Alwwex/Projekt_velky/hardware/kicad/drc_report.txt

** Drc report for /home/user/Projekt_velky/hardware/kicad/laserplan.kicad_pcb **
** Created on 2026-11-11 16:36:16 **

** Found 56 DRC violations **
[lib_footprint_issues]: The current configuration does not include the library 'Resistor_SMD'.
    Local override; Severity: warning
    @(145.0000 mm, 126.5000 mm): Footprint R19
[lib_footprint_issues]: The current configuration does not include the library 'Resistor_SMD'.
    Local override; Severity: warning
    @(136.5000 mm, 104.6000 mm): Footprint R7
[lib_footprint_issues]: The current configuration does not include the library 'MountingHole'.
    Local override; Severity: warning
    @(103.2000 mm, 140.8000 mm): Footprint H3
[lib_footprint_issues]: The current configuration does not include the library 'Resistor_SMD'.
    Local override; Severity: warning
    @(172.2000 mm, 109.6000 mm): Footprint R11
[lib_footprint_issues]: The current configuration does not include the library 'LED_SMD'.
    Local override; Severity: warning
    @(186.7000 mm, 136.5000 mm): Footprint D3
[lib_footprint_issues]: The current configuration does not include the library 'Capacitor_SMD'.
    Local override; Severity: warning
    @(159.2000 mm, 133.5000 mm): Footprint C10
[lib_footprint_issues]: The current configuration does not include the library 'Resistor_SMD'.
    Local override; Severity: warning
    @(179.0000 mm, 129.4000 mm): Footprint R1
[lib_footprint_issues]: The current configuration does not include the library 'Resistor_SMD'.
    Local override; Severity: warning
    @(157.0000 mm, 133.5000 mm): Footprint R15
[lib_footprint_issues]: The current configuration does not include the library 'Connector_PinSocket_2.54mm'.
    Local override; Severity: warning
    @(130.5000 mm, 117.1900 mm): Footprint J3
[lib_footprint_issues]: The current configuration does not include the library 'Capacitor_SMD'.
    Local override; Severity: warning
    @(175.4000 mm, 105.6000 mm): Footprint C4
[lib_footprint_issues]: The current configuration does not include the library 'Package_TO_SOT_SMD'.
    Local override; Severity: warning
    @(175.0000 mm, 126.0000 mm): Footprint Q1
[lib_footprint_issues]: The current configuration does not include the library 'Capacitor_SMD'.
    Local override; Severity: warning
    @(136.5000 mm, 107.2000 mm): Footprint C7
[lib_footprint_issues]: The current configuration does not include the library 'Button_Switch_THT'.
    Local override; Severity: warning
    @(134.5000 mm, 111.5000 mm): Footprint SW3
[lib_footprint_issues]: The current configuration does not include the library 'Capacitor_SMD'.
    Local override; Severity: warning
    @(170.8000 mm, 133.0000 mm): Footprint C2
[lib_footprint_issues]: The current configuration does not include the library 'MountingHole'.
    Local override; Severity: warning
    @(186.8000 mm, 140.8000 mm): Footprint H4
[lib_footprint_issues]: The current configuration does not include the library 'Package_TO_SOT_SMD'.
    Local override; Severity: warning
    @(151.0000 mm, 137.0000 mm): Footprint Q2
[lib_footprint_issues]: The current configuration does not include the library 'Resistor_SMD'.
    Local override; Severity: warning
    @(164.0000 mm, 128.5000 mm): Footprint R16
[lib_footprint_issues]: The current configuration does not include the library 'Resistor_SMD'.
    Local override; Severity: warning
    @(157.5000 mm, 129.0000 mm): Footprint R17
[lib_footprint_issues]: The current configuration does not include the library 'MountingHole'.
    Local override; Severity: warning
    @(103.2000 mm, 103.2000 mm): Footprint H1
[lib_footprint_issues]: The current configuration does not include the library 'Connector_JST'.
    Local override; Severity: warning
    @(174.0000 mm, 139.6000 mm): Footprint J4
[lib_footprint_issues]: The current configuration does not include the library 'LED_SMD'.
    Local override; Severity: warning
    @(186.7000 mm, 134.0000 mm): Footprint D2
[lib_footprint_issues]: The current configuration does not include the library 'Resistor_SMD'.
    Local override; Severity: warning
    @(177.8000 mm, 125.5000 mm): Footprint R6
[lib_footprint_issues]: The current configuration does not include the library 'Resistor_SMD'.
    Local override; Severity: warning
    @(175.8000 mm, 109.6000 mm): Footprint R12
[lib_footprint_issues]: The current configuration does not include the library 'LED_SMD'.
    Local override; Severity: warning
    @(145.0000 mm, 129.0000 mm): Footprint D5
[lib_footprint_issues]: The current configuration does not include the library 'Resistor_SMD'.
    Local override; Severity: warning
    @(168.5000 mm, 109.0000 mm): Footprint R9
[lib_footprint_issues]: The current configuration does not include the library 'Diode_SMD'.
    Local override; Severity: warning
    @(147.5000 mm, 136.2000 mm): Footprint D4
[lib_footprint_issues]: The current configuration does not include the library 'MountingHole'.
    Local override; Severity: warning
    @(186.8000 mm, 103.2000 mm): Footprint H2
[lib_footprint_issues]: The current configuration does not include the library 'Diode_SMD'.
    Local override; Severity: warning
    @(175.0000 mm, 121.5000 mm): Footprint D1
[lib_footprint_issues]: The current configuration does not include the library 'Package_TO_SOT_SMD'.
    Local override; Severity: warning
    @(174.5000 mm, 133.0000 mm): Footprint U2
[lib_footprint_issues]: The current configuration does not include the library 'Package_TO_SOT_SMD'.
    Local override; Severity: warning
    @(161.0000 mm, 129.0000 mm): Footprint Q3
[lib_footprint_issues]: The current configuration does not include the library 'Resistor_SMD'.
    Local override; Severity: warning
    @(179.0000 mm, 119.0000 mm): Footprint R2
[lib_footprint_issues]: The current configuration does not include the library 'Capacitor_SMD'.
    Local override; Severity: warning
    @(178.5000 mm, 133.0000 mm): Footprint C1
[lib_footprint_issues]: The current configuration does not include the library 'Package_TO_SOT_SMD'.
    Local override; Severity: warning
    @(149.0000 mm, 131.5000 mm): Footprint Q4
[lib_footprint_issues]: The current configuration does not include the library 'Buzzer_Beeper'.
    Local override; Severity: warning
    @(135.5000 mm, 137.6000 mm): Footprint BZ1
[lib_footprint_issues]: The current configuration does not include the library 'Resistor_SMD'.
    Local override; Severity: warning
    @(145.5000 mm, 123.3000 mm): Footprint R10
[lib_footprint_issues]: The current configuration does not include the library 'Package_TO_SOT_SMD'.
    Local override; Severity: warning
    @(178.5000 mm, 105.5000 mm): Footprint U3
[lib_footprint_issues]: The current configuration does not include the library 'Capacitor_SMD'.
    Local override; Severity: warning
    @(181.6000 mm, 105.6000 mm): Footprint C3
[lib_footprint_issues]: The current configuration does not include the library 'Connector_USB'.
    Local override; Severity: warning
    @(186.3000 mm, 124.0000 mm): Footprint J1
[lib_footprint_issues]: The current configuration does not include the library 'Capacitor_SMD'.
    Local override; Severity: warning
    @(179.4000 mm, 109.6000 mm): Footprint C8
[lib_footprint_issues]: The current configuration does not include the library 'Resistor_SMD'.
    Local override; Severity: warning
    @(183.2000 mm, 136.5000 mm): Footprint R5
[lib_footprint_issues]: The current configuration does not include the library 'Capacitor_SMD'.
    Local override; Severity: warning
    @(141.0000 mm, 104.6000 mm): Footprint C5
[lib_footprint_issues]: The current configuration does not include the library 'RF_Module'.
    Local override; Severity: warning
    @(157.0000 mm, 113.3500 mm): Footprint U4
[lib_footprint_issues]: The current configuration does not include the library 'Jumper'.
    Local override; Severity: warning
    @(153.0000 mm, 127.0000 mm): Footprint JP1
[lib_footprint_issues]: The current configuration does not include the library 'Button_Switch_THT'.
    Local override; Severity: warning
    @(122.0000 mm, 102.2500 mm): Footprint SW1
[lib_footprint_issues]: The current configuration does not include the library 'Capacitor_SMD'.
    Local override; Severity: warning
    @(154.5000 mm, 137.0000 mm): Footprint C9
[lib_footprint_issues]: The current configuration does not include the library 'Button_Switch_THT'.
    Local override; Severity: warning
    @(134.5000 mm, 122.5000 mm): Footprint SW2
[lib_footprint_issues]: The current configuration does not include the library 'Resistor_SMD'.
    Local override; Severity: warning
    @(152.5000 mm, 131.5000 mm): Footprint R18
[lib_footprint_issues]: The current configuration does not include the library 'Resistor_SMD'.
    Local override; Severity: warning
    @(183.2000 mm, 134.0000 mm): Footprint R4
[lib_footprint_issues]: The current configuration does not include the library 'Resistor_SMD'.
    Local override; Severity: warning
    @(149.5000 mm, 123.3000 mm): Footprint R8
[lib_footprint_issues]: The current configuration does not include the library 'Capacitor_SMD'.
    Local override; Severity: warning
    @(141.0000 mm, 107.2000 mm): Footprint C6
[lib_footprint_issues]: The current configuration does not include the library 'Resistor_SMD'.
    Local override; Severity: warning
    @(144.5000 mm, 110.0000 mm): Footprint R20
[lib_footprint_issues]: The current configuration does not include the library 'Resistor_SMD'.
    Local override; Severity: warning
    @(174.5000 mm, 129.6000 mm): Footprint R3
[lib_footprint_issues]: The current configuration does not include the library 'Package_TO_SOT_SMD'.
    Local override; Severity: warning
    @(170.8000 mm, 114.1000 mm): Footprint U1
[lib_footprint_issues]: The current configuration does not include the library 'Resistor_SMD'.
    Local override; Severity: warning
    @(184.0000 mm, 112.0000 mm): Footprint R13
[lib_footprint_issues]: The current configuration does not include the library 'Connector_PinHeader_2.54mm'.
    Local override; Severity: warning
    @(149.0000 mm, 141.6000 mm): Footprint J2
[lib_footprint_issues]: The current configuration does not include the library 'Resistor_SMD'.
    Local override; Severity: warning
    @(184.0000 mm, 108.6000 mm): Footprint R14

** Found 0 unconnected pads **

** Found 0 Footprint errors **

** End of Report **
