Alwwex/Projekt_velky/hardware/vyroba/bom-jlcpcb.csv

Comment | Designator | Footprint | LCSC Part # | MPN
10u | C1,C2,C3,C4,C5,C9 | C_0805_2012Metric |  | 0805 10u X5R/X7R ≥10V
10n | C10 | C_0805_2012Metric |  | 0805 10n X5R/X7R ≥10V
100n | C6,C8 | C_0805_2012Metric |  | 0805 100n X5R/X7R ≥10V
1u | C7 | C_0805_2012Metric |  | 0805 1u X5R/X7R ≥10V
B5819W | D1 | D_SOD-123 |  | B5819W
LED červená | D2 | LED_0805_2012Metric |  | LED 0805 červená
LED zelená | D3 | LED_0805_2012Metric |  | LED 0805 zelená
1N4148W | D4 | D_SOD-123 |  | 1N4148W
LED modrá | D5 | LED_0805_2012Metric |  | LED 0805 modrá
USB-C | J1 | USB_C_Receptacle_HRO_TYPE-C-31-M-12 |  | TYPE-C-31-M-12
AO3401A | Q1,Q2 | SOT-23 |  | AO3401A
AO3400A | Q3,Q4 | SOT-23 |  | AO3400A
5.1k | R1,R2 | R_0805_2012Metric |  | 0805 5.1k 1%
47k | R13 | R_0805_2012Metric |  | 0805 47k 1%
68k | R14 | R_0805_2012Metric |  | 0805 68k 1%
2.2k | R3 | R_0805_2012Metric |  | 0805 2.2k 1%
1k | R4,R5,R19 | R_0805_2012Metric |  | 0805 1k 1%
100k | R6,R11,R12,R15,R16,R18 | R_0805_2012Metric |  | 0805 100k 1%
10k | R7,R8,R9,R10,R17,R20 | R_0805_2012Metric |  | 0805 10k 1%
USBLC6-2SC6 | U1 | SOT-23-6 |  | USBLC6-2SC6
MCP73831-2-OT | U2 | SOT-23-5 |  | MCP73831T-2ACI/OT
AP2112K-3.3 | U3 | SOT-23-5 |  | AP2112K-3.3TRG1
ESP32-C3-WROOM-02-N4 | U4 | ESP32-C3-WROOM-02 |  | ESP32-C3-WROOM-02-N4
