Alwwex/Projekt_velky/hardware/krabicka/vicko.stl

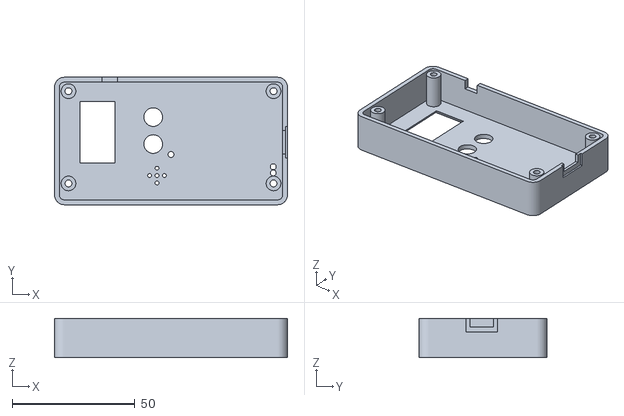
[picture p6: CAD file, 2026-11-11]
hardware/krabicka/vicko.stl
95.0 x 52.0 x 16.0
