Alwwex/Projekt_velky/hardware/vyroba/laserplan.step

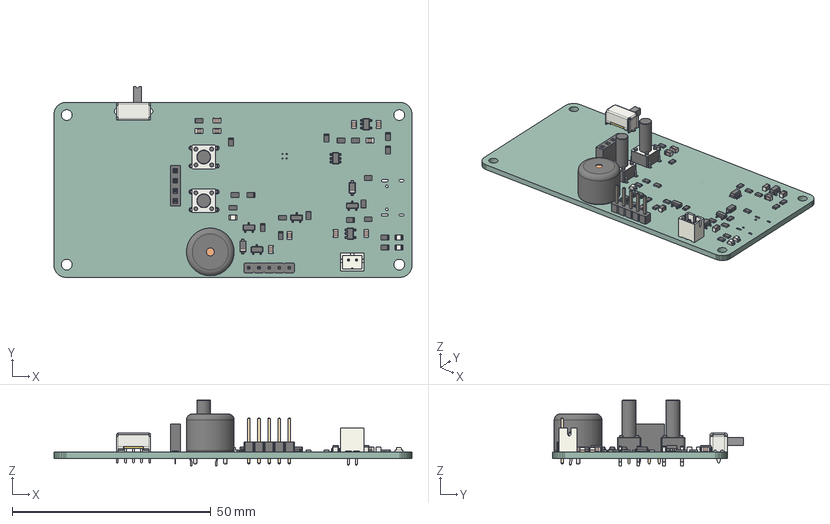
[picture p7: CAD file, 2026-11-11]
hardware/vyroba/laserplan.step
90.0 x 48.0 x 16.5 mm
R_0805_2012Metric x 20
LED_0805_2012Metric x 3
C_0805_2012Metric x 10
PinSocket_1x04_P254mm_Vertical
SOT_23 x 4
SW_PUSH_6mm_h13mm x 2
JST_B2B_PH_K
D_SOD_123 x 2
SOT_23_5 x 2
Buzzer_12x95RM76
SW_Slide_SPDT_Angled_CK_OS102011MA1Q
SOT_23_6
PinHeader_1x05_P254mm_Vertical
laserplan PCB
