Alwwex/Projekt_velky/hardware/krabicka/spodek.stl

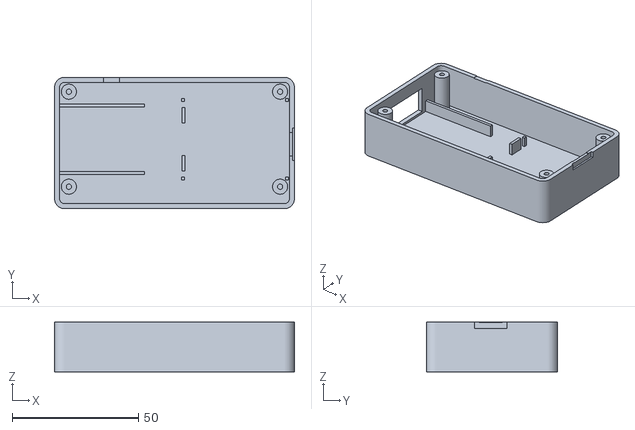
[picture p8: CAD file, 2026-11-11]
hardware/krabicka/spodek.stl
95.0 x 52.0 x 19.6
