Alwwex/Projekt_velky/hardware/krabicka/hmatnik.stl

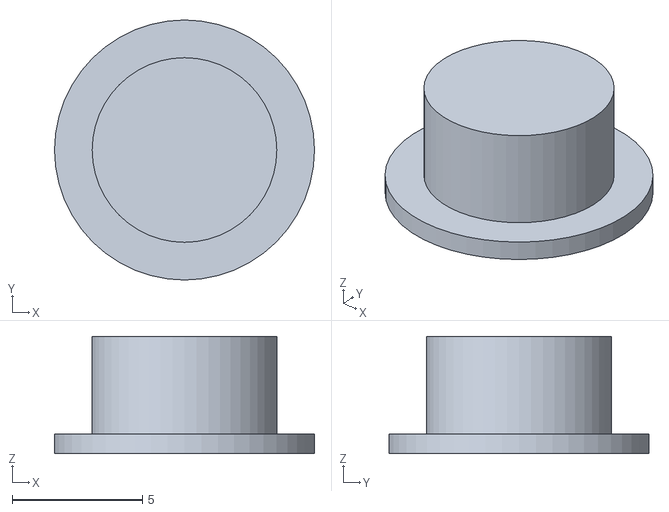
[picture p9: CAD file, 2026-11-11]
hardware/krabicka/hmatnik.stl
10.0 x 10.0 x 4.50
