Alwwex/Projekt_velky/hardware/vyroba/schema.pdf

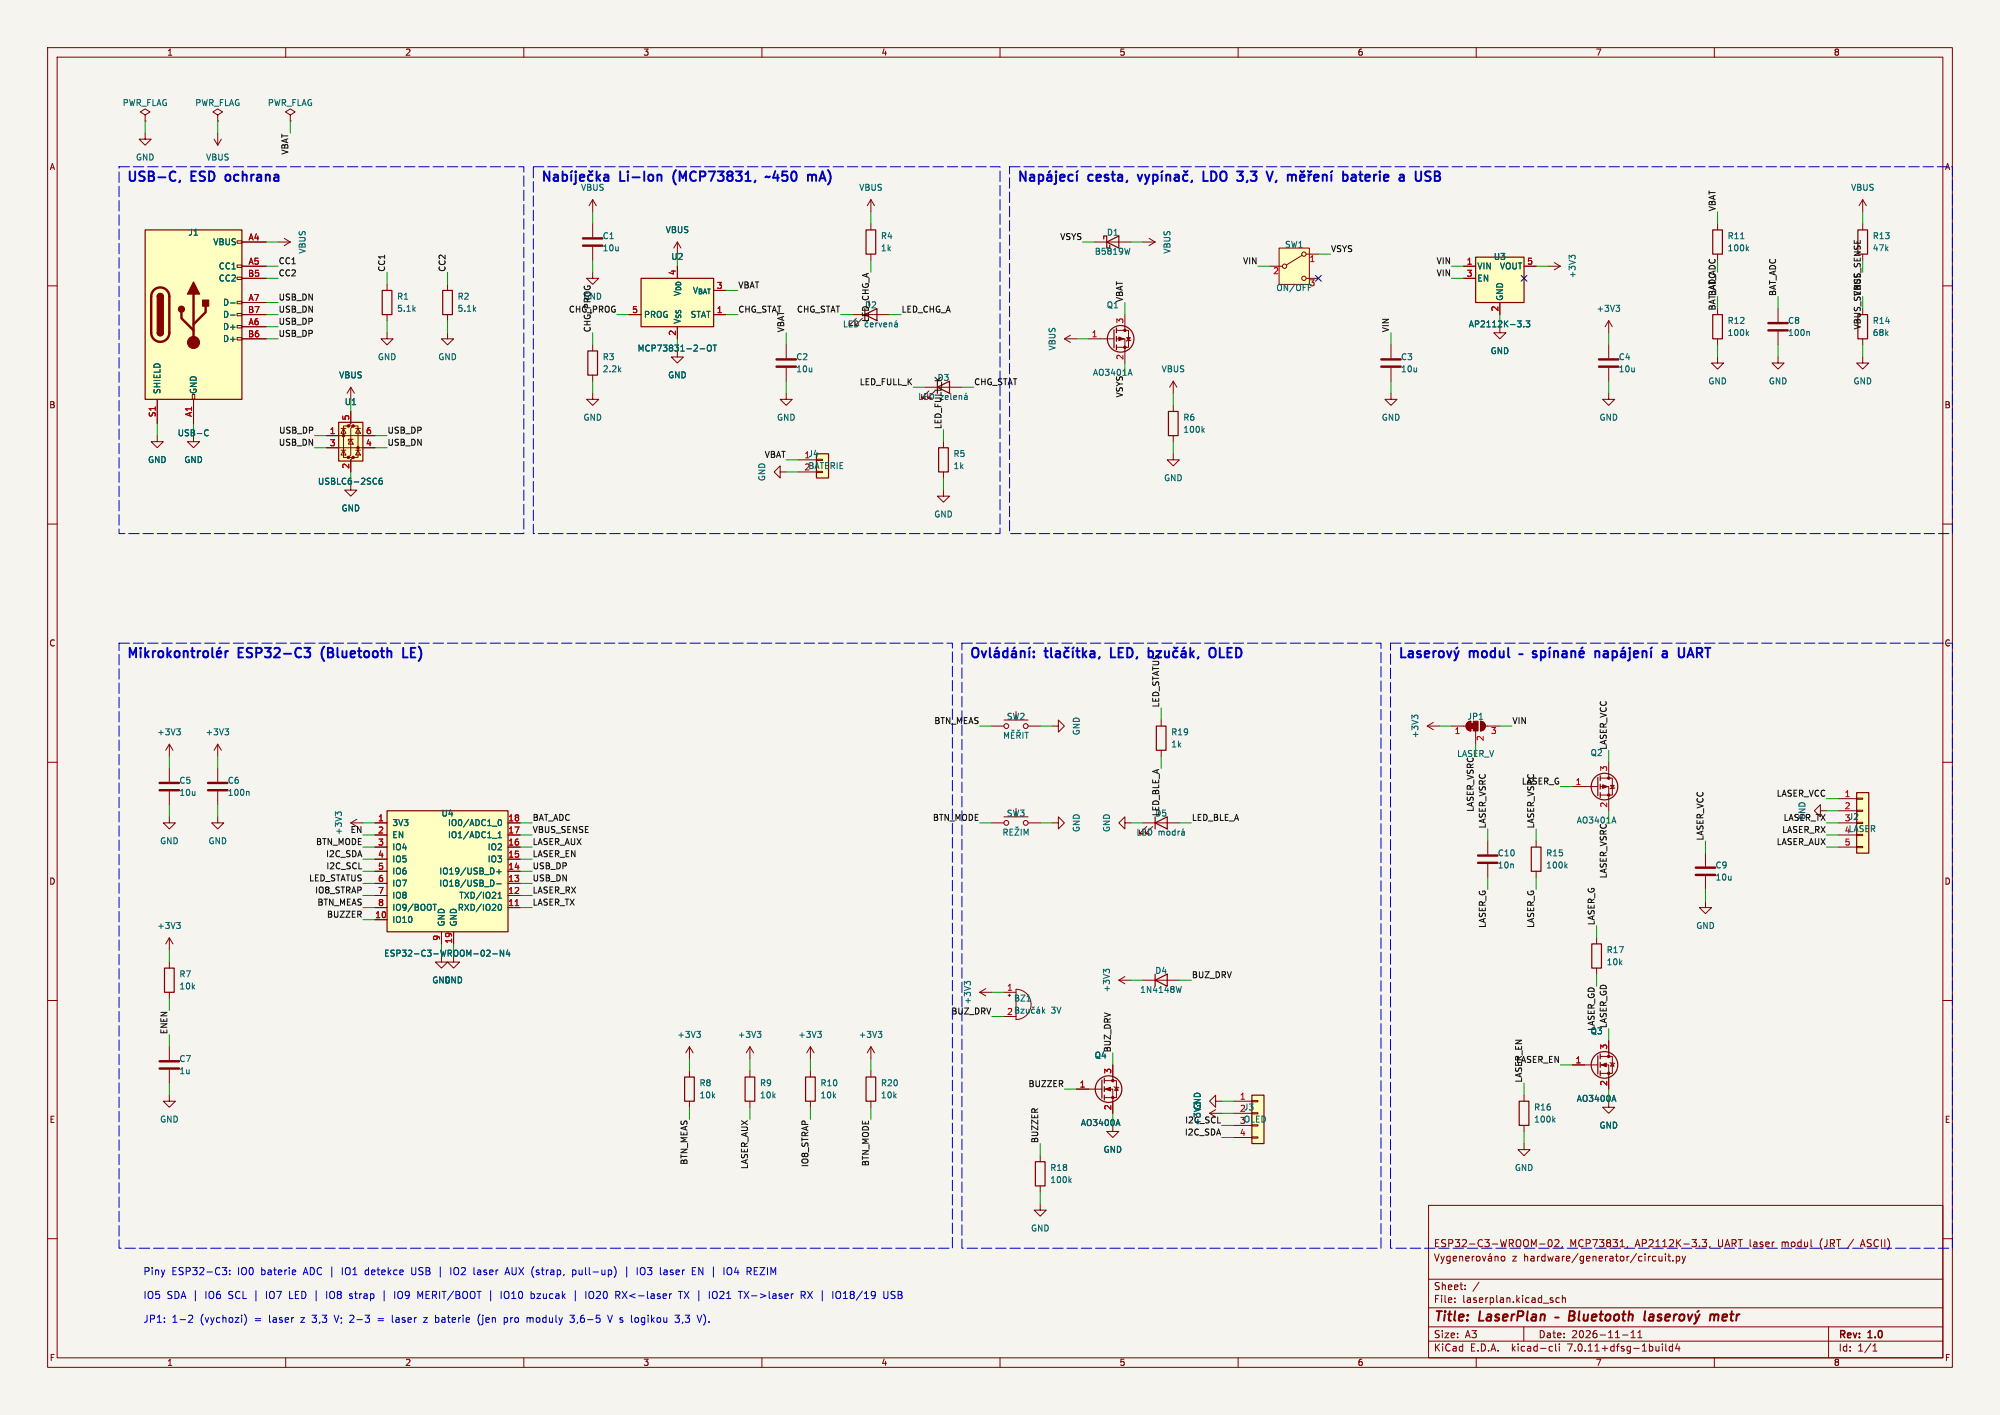
[picture p10: page 1]

, LDO 3,3 V, þÿmYení baterie a USB

2 3 Q3 AO3400A GND GND A1 VBUS A4 CC1 A5 D+ A6 D- A7 CC2 B5 D+ B6 D- B7 SHIELD S1

2 EN 3 VOUT 5 GND GND
