Alwwex/Projekt_velky/hardware/kicad/laserplan.kicad_pcb

## KiCad design hardware/kicad/laserplan.kicad_pcb (2026-11-11)

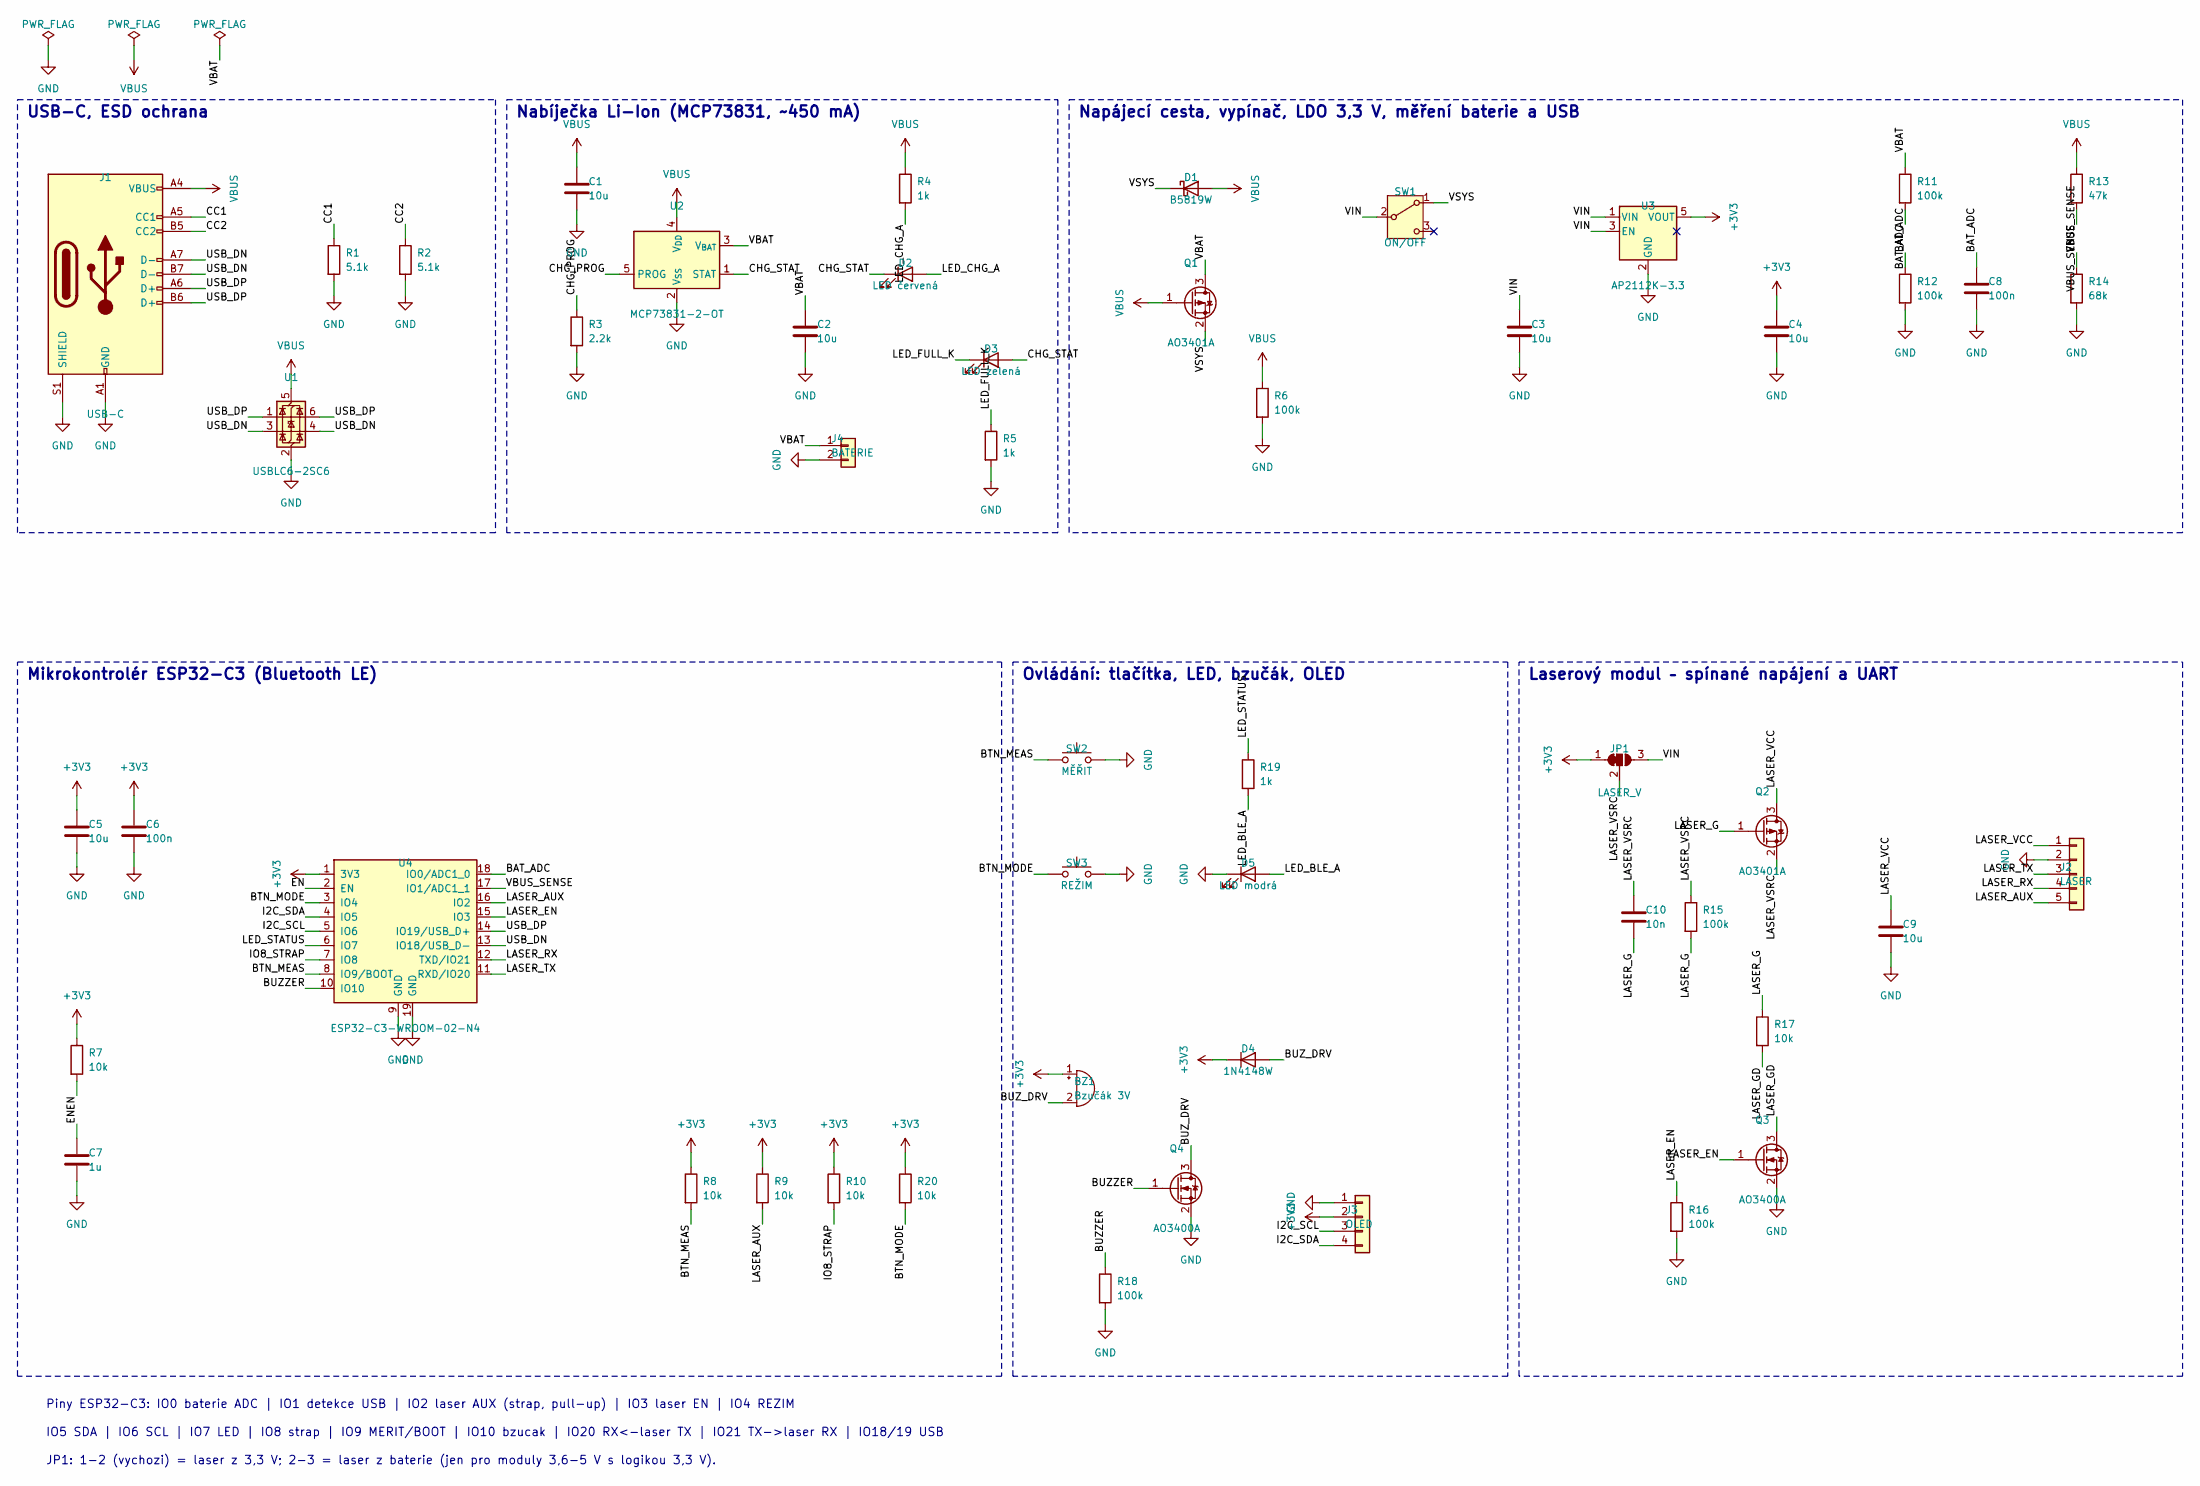
[picture p11: schematic laserplan.kicad_sch, LaserPlan – Bluetooth laserový metr]

Parts:
BZ1: Bzučák 3V; Buzzer_12x9.5RM7.6; MPN Pasivní magnetický bzučák 12×9,5 mm, 3 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
C1, C2, C3, C4, C5, C9: 10u; C_0805_2012Metric; MPN 0805 10u X5R/X7R ≥10V
C6, C8: 100n; C_0805_2012Metric; MPN 0805 100n X5R/X7R ≥10V
C7: 1u; C_0805_2012Metric; MPN 0805 1u X5R/X7R ≥10V
C10: 10n; C_0805_2012Metric; MPN 0805 10n X5R/X7R ≥10V
D1: B5819W; D_SOD-123; MPN B5819W
D2: LED červená; LED_0805_2012Metric; MPN LED 0805 červená
D3: LED zelená; LED_0805_2012Metric; MPN LED 0805 zelená
D4: 1N4148W; D_SOD-123; MPN 1N4148W
D5: LED modrá; LED_0805_2012Metric; MPN LED 0805 modrá
J1: USB-C; USB_C_Receptacle_HRO_TYPE-C-31-M-12; MPN TYPE-C-31-M-12
J2: LASER; PinHeader_1x05_P2.54mm_Vertical; MPN Kolíková lišta 1×5, 2,54 mm
J3: OLED; PinSocket_1x04_P2.54mm_Vertical; MPN Dutinková lišta 1×4, 2,54 mm
J4: BATERIE; JST_PH_B2B-PH-K_1x02_P2.00mm_Vertical; MPN B2B-PH-K-S
JP1: LASER_V; SolderJumper-3_P1.3mm_Bridged12_RoundedPad1.0x1.5mm; MPN (pájecí propojka na DPS)
Q1, Q2: AO3401A; SOT-23; MPN AO3401A
Q3, Q4: AO3400A; SOT-23; MPN AO3400A
R1, R2: 5.1k; R_0805_2012Metric; MPN 0805 5.1k 1%
R3: 2.2k; R_0805_2012Metric; MPN 0805 2.2k 1%
R4, R5, R19: 1k; R_0805_2012Metric; MPN 0805 1k 1%
R6, R11, R12, R15, R16, R18: 100k; R_0805_2012Metric; MPN 0805 100k 1%
R7, R8, R9, R10, R17, R20: 10k; R_0805_2012Metric; MPN 0805 10k 1%
R13: 47k; R_0805_2012Metric; MPN 0805 47k 1%
R14: 68k; R_0805_2012Metric; MPN 0805 68k 1%
SW1: ON/OFF; SW_Slide_SPDT_Angled_CK_OS102011MA1Q; MPN OS102011MA1QN1
SW2: MĚŘIT; SW_PUSH_6mm_H13mm; MPN TS-1187A / B3F-1070 (6×6 mm, výška 13 m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
SW3: REŽIM; SW_PUSH_6mm_H13mm; MPN TS-1187A / B3F-1070 (6×6 mm, výška 13 m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
U1: USBLC6-2SC6; SOT-23-6; MPN USBLC6-2SC6
U2: MCP73831-2-OT; SOT-23-5; MPN MCP73831T-2ACI/OT
U3: AP2112K-3.3; SOT-23-5; MPN AP2112K-3.3TRG1
U4: ESP32-C3-WROOM-02-N4; ESP32-C3-WROOM-02; MPN ESP32-C3-WROOM-02-N4

Connections:
+3V3: BZ1.1 (+), C4.1, C5.1, C6.1, D4.1 (K), J3.2, JP1.1 (A), R7.1, R8.1, R9.1, R10.1, R20.1, U3.5 (VOUT), U4.1 (3V3)
BAT_ADC: C8.1, R11.2, R12.1, U4.18 (IO0/ADC1_0)
BTN_MEAS: R8.2, SW2.1, U4.8 (IO9/BOOT)
BTN_MODE: R20.2, SW3.1, U4.3 (IO4)
BUZZER: Q4.1 (G), R18.1, U4.10 (IO10)
BUZ_DRV: BZ1.2 (-), D4.2 (A), Q4.3 (D)
CC1: J1.A5 (CC1), R1.1
CC2: J1.B5 (CC2), R2.1
CHG_PROG: R3.1, U2.5 (PROG)
CHG_STAT: D2.1 (K), D3.2 (A), U2.1 (STAT)
EN: C7.1, R7.2, U4.2 (EN)
GND: C1.2, C2.2, C3.2, C4.2, C5.2, C6.2, C7.2, C8.2, C9.2, D5.1 (K), J1.A1 (GND), J1.A12 (GND), J1.B1 (GND), J1.B12 (GND), J1.S1 (SHIELD), J2.2, J3.1, J4.2, Q3.2 (S), Q4.2 (S), R1.2, R2.2, R3.2, R5.2, R6.2, R12.2, R14.2, R16.2, R18.2, SW2.2, SW3.2, U1.2 (GND), U2.2 (V_{SS}), U3.2 (GND), U4.9 (GND), U4.19 (GND)
I2C_SCL: J3.3, U4.5 (IO6)
I2C_SDA: J3.4, U4.4 (IO5)
IO8_STRAP: R10.2, U4.7 (IO8)
LASER_AUX: J2.5, R9.2, U4.16 (IO2)
LASER_EN: Q3.1 (G), R16.1, U4.15 (IO3)
LASER_G: C10.2, Q2.1 (G), R15.2, R17.1
LASER_GD: Q3.3 (D), R17.2
LASER_RX: J2.4, U4.12 (TXD/IO21)
LASER_TX: J2.3, U4.11 (RXD/IO20)
LASER_VCC: C9.1, J2.1, Q2.3 (D)
LASER_VSRC: C10.1, JP1.2 (C), Q2.2 (S), R15.1
LED_BLE_A: D5.2 (A), R19.2
LED_CHG_A: D2.2 (A), R4.2
LED_FULL_K: D3.1 (K), R5.1
LED_STATUS: R19.1, U4.6 (IO7)
USB_DN: J1.A7 (D-), J1.B7 (D-), U1.3 (I/O2), U1.4 (I/O2), U4.13 (IO18/USB_D-)
USB_DP: J1.A6 (D+), J1.B6 (D+), U1.1 (I/O1), U1.6 (I/O1), U4.14 (IO19/USB_D+)
VBAT: C2.1, J4.1, Q1.3 (D), R11.1, U2.3 (V_{BAT})
VBUS: C1.1, D1.2 (A), J1.A4 (VBUS), J1.A9 (VBUS), J1.B4 (VBUS), J1.B9 (VBUS), Q1.1 (G), R4.1, R6.1, R13.1, U1.5 (VBUS), U2.4 (V_{DD})
VBUS_SENSE: R13.2, R14.1, U4.17 (IO1/ADC1_1)
VIN: C3.1, JP1.3 (B), SW1.2 (B), U3.1 (VIN), U3.3 (EN)
VSYS: D1.1 (K), Q1.2 (S), SW1.1 (A)

Notes on the sheet:
USB-C, ESD ochrana
Nabíječka Li-Ion (MCP73831, ~450 mA)
Napájecí cesta, vypínač, LDO 3,3 V, měření baterie a USB
Mikrokontrolér ESP32-C3 (Bluetooth LE)
Ovládání: tlačítka, LED, bzučák, OLED
Laserový modul – spínané napájení a UART
Piny ESP32-C3: IO0 baterie ADC | IO1 detekce USB | IO2 laser AUX (strap, pull-up) | IO3 laser EN | IO4 REZIM
IO5 SDA | IO6 SCL | IO7 LED | IO8 strap | IO9 MERIT/BOOT | IO10 bzucak | IO20 RX<-laser TX | IO21 TX->laser RX | IO18/19 USB
JP1: 1-2 (vychozi) = laser z 3,3 V; 2-3 = laser z baterie (jen pro moduly 3,6-5 V s logikou 3,3 V).

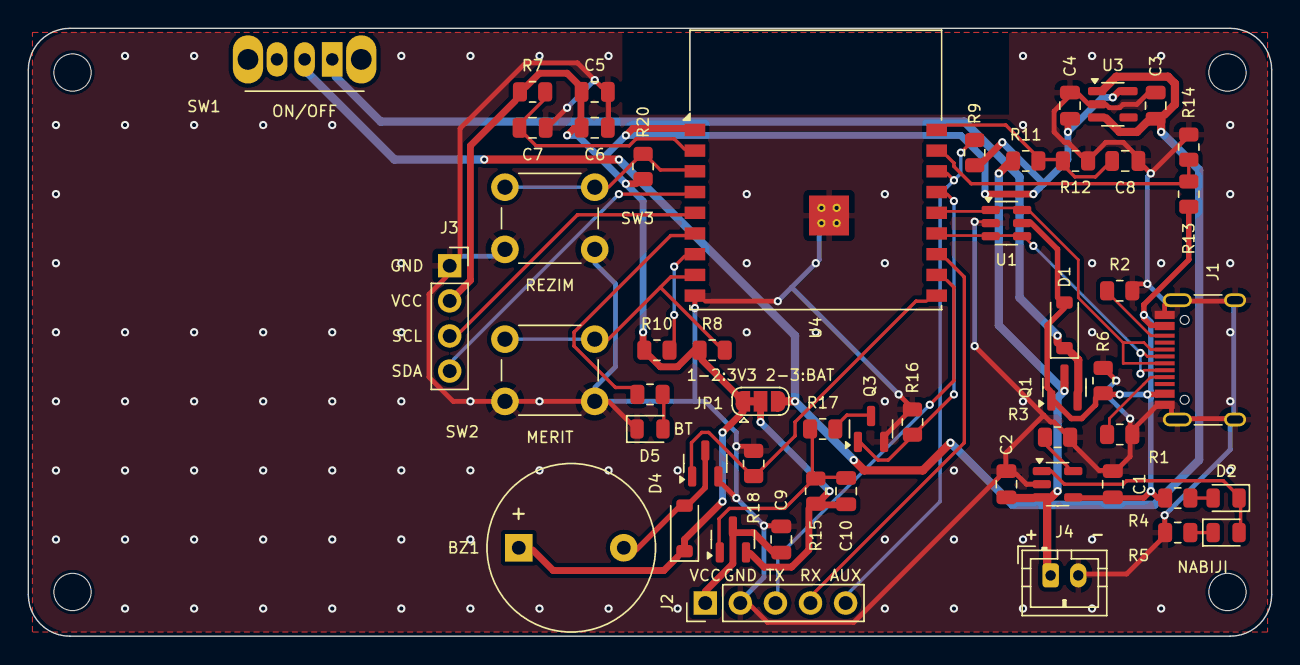
[picture p12: board laserplan.kicad_pcb from above]

Board: 2 copper layers, 90.0 x 44.0 mm, 56 parts (0 on the bottom side), 34 nets.

Other parts of the board:
H1, H2, H3, H4: M2.5; MountingHole_2.7mm_M2.5
